jppang/X-TRACK/Hardware/README.md

## 编译
* 参见: [编译说明](https://github.com/FASTSHIFT/X-TRACK/blob/main/Software/README.md)

## 硬件修改
* PCB打样的厚度选择**0.8mm**或**1mm**。
* 去除**D4**二极管，防止充电时自动开机，导致充电变慢和发热。
* 注意**D2**二极管方向，方向是和其他二极管相反的。否则会发生开机一段时间自动关机的情况。
* GPS模块需要由**HT1818Z3G5L**更换为**ATGM336H**(购买链接在下方)，否则外壳放不下。关于接线，GPS模块的**TX**脚接板子的**T焊盘**,**RX**脚接板子的**R焊盘**。
* 地磁计**LIS3MDL**和加速度计**LSM6DSM**在该系统中作用不大，又由于芯片涨价导致整机成本过高，可以不安装。
* MCU: **AT32F403ACGU7**，如果定不到货，可以尝试[@johnsbark](https://github.com/johnsbark)设计的[改进版硬件](https://github.com/FASTSHIFT/X-TRACK/tree/main/Hardware/X-TRACK%20%E6%94%B9%E8%BF%9B%E7%89%88)方案（红框内的MCU都可以进行尝试）。
_@~ (1`XC( S{MQFDXTSZQQ
* 关于其他品牌MCU替换的性能需求: 主频 >150M，RAM >=200K，FLASH >=512K，SPI速度 >=50Mbps。 

## 特殊器件购买链接
* 电池 (选择 683030) https://detail.tmall.com/item.htm?id=634173891714
* 旋转编码器 https://item.taobao.com/item.htm?id=598028191617
* 屏幕 (选择 裸屏) https://item.taobao.com/item.htm?id=600653923469
* 调试口 (选择 4P弯针) https://item.taobao.com/item.htm?id=522574977704
* 码表底座 (选择 竖向按装拓展片孔距M3*20~21mm[塑胶材料 3g]) https://item.taobao.com/item.htm?id=599529362799
* GPS模块 (ATGM336H) https://item.taobao.com/item.htm?id=603186739934
* AON3400 (AO3400 N沟道MOS管) https://item.taobao.com/item.htm?id=522574089119
* 侧盖螺丝 https://item.taobao.com/item.htm?id=522574685586
* Pad (焊接电池线的焊盘，非实体元件)

## 焊接
* [焊接教程](https://github.com/FASTSHIFT/X-TRACK/blob/main/Hardware/%E7%84%8A%E6%8E%A5%E8%B0%83%E8%AF%95%E6%8C%87%E5%8C%97.md)

## 2.0寸屏版本
https://github.com/FASTSHIFT/X-TRACK/tree/2.0-inch by[@HanfG](https://github.com/HanfG)
