jppang/X-TRACK/Hardware/KiCad/README.md

使用KiCad來重新設計X-TRACK之原理圖及電路圖。

Utilizing KiCad to redesign X-TRACK's schematic and pcb layout.

X-Track_3D_Back_V2

X-Track_3D_Front_V2
