jppang/X-TRACK/Hardware/KiCad/doc/taobao_typec_usb2_16pins.jpg

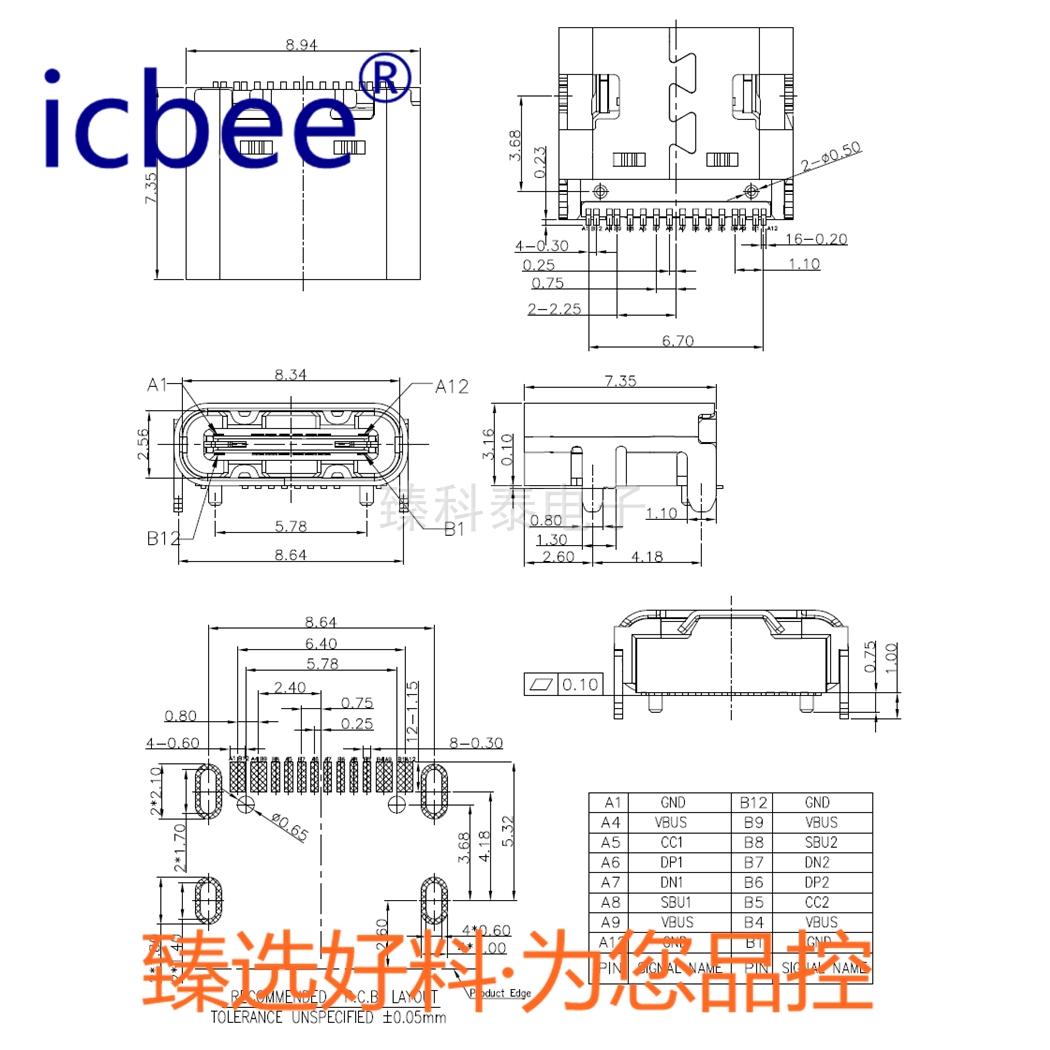
Hardware/KiCad/doc/taobao_typec_usb2_16pins.jpg
