jppang/X-TRACK/3D Model/X-Track-Back.stl

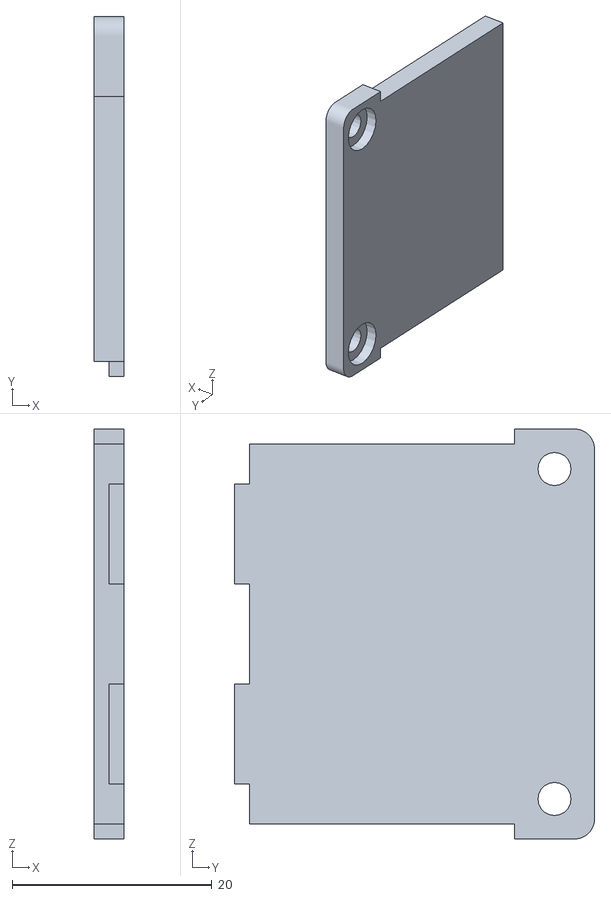
[picture p8: CAD file, 2022-02-01]
3D Model/X-Track-Back.stl
3.00 x 36.0 x 41.0
