jppang/X-TRACK/3D Model/X-Track-Front.stl

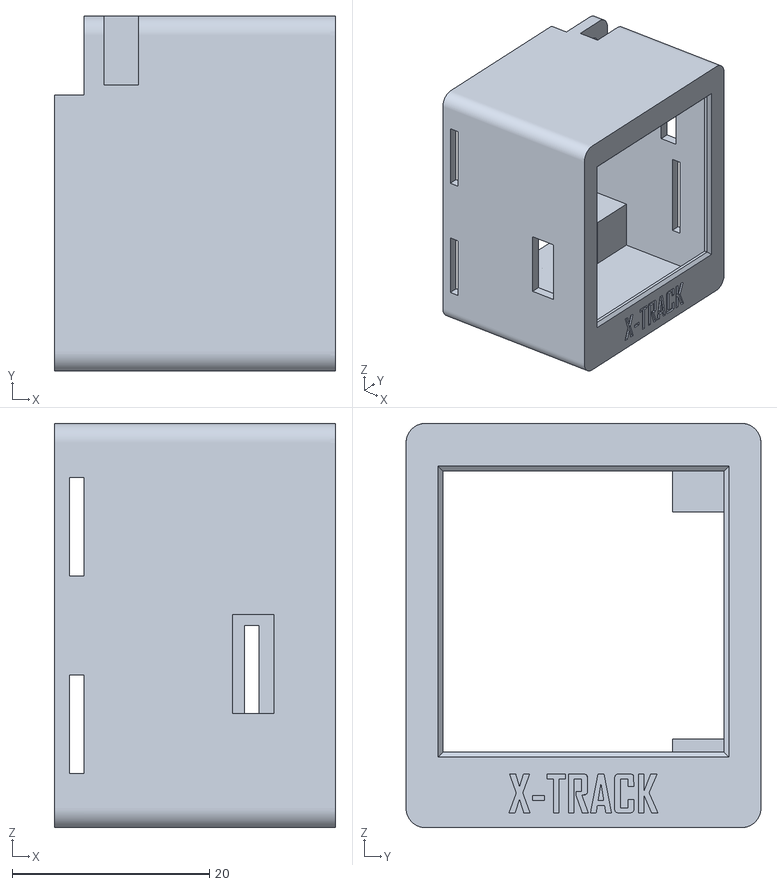
[picture p9: CAD file, 2022-02-01]
3D Model/X-Track-Front.stl
28.5 x 36.0 x 41.0
