jppang/X-TRACK/(list of files, cad)

Other CAD files:
Hardware/KiCad/doc/ZJYIPS154-12/drawing.dwg
