jppang/X-TRACK/Hardware/KiCad/X-Track.kicad_pcb

## KiCad design Hardware/KiCad/X-Track.kicad_pcb (2021-12-23)

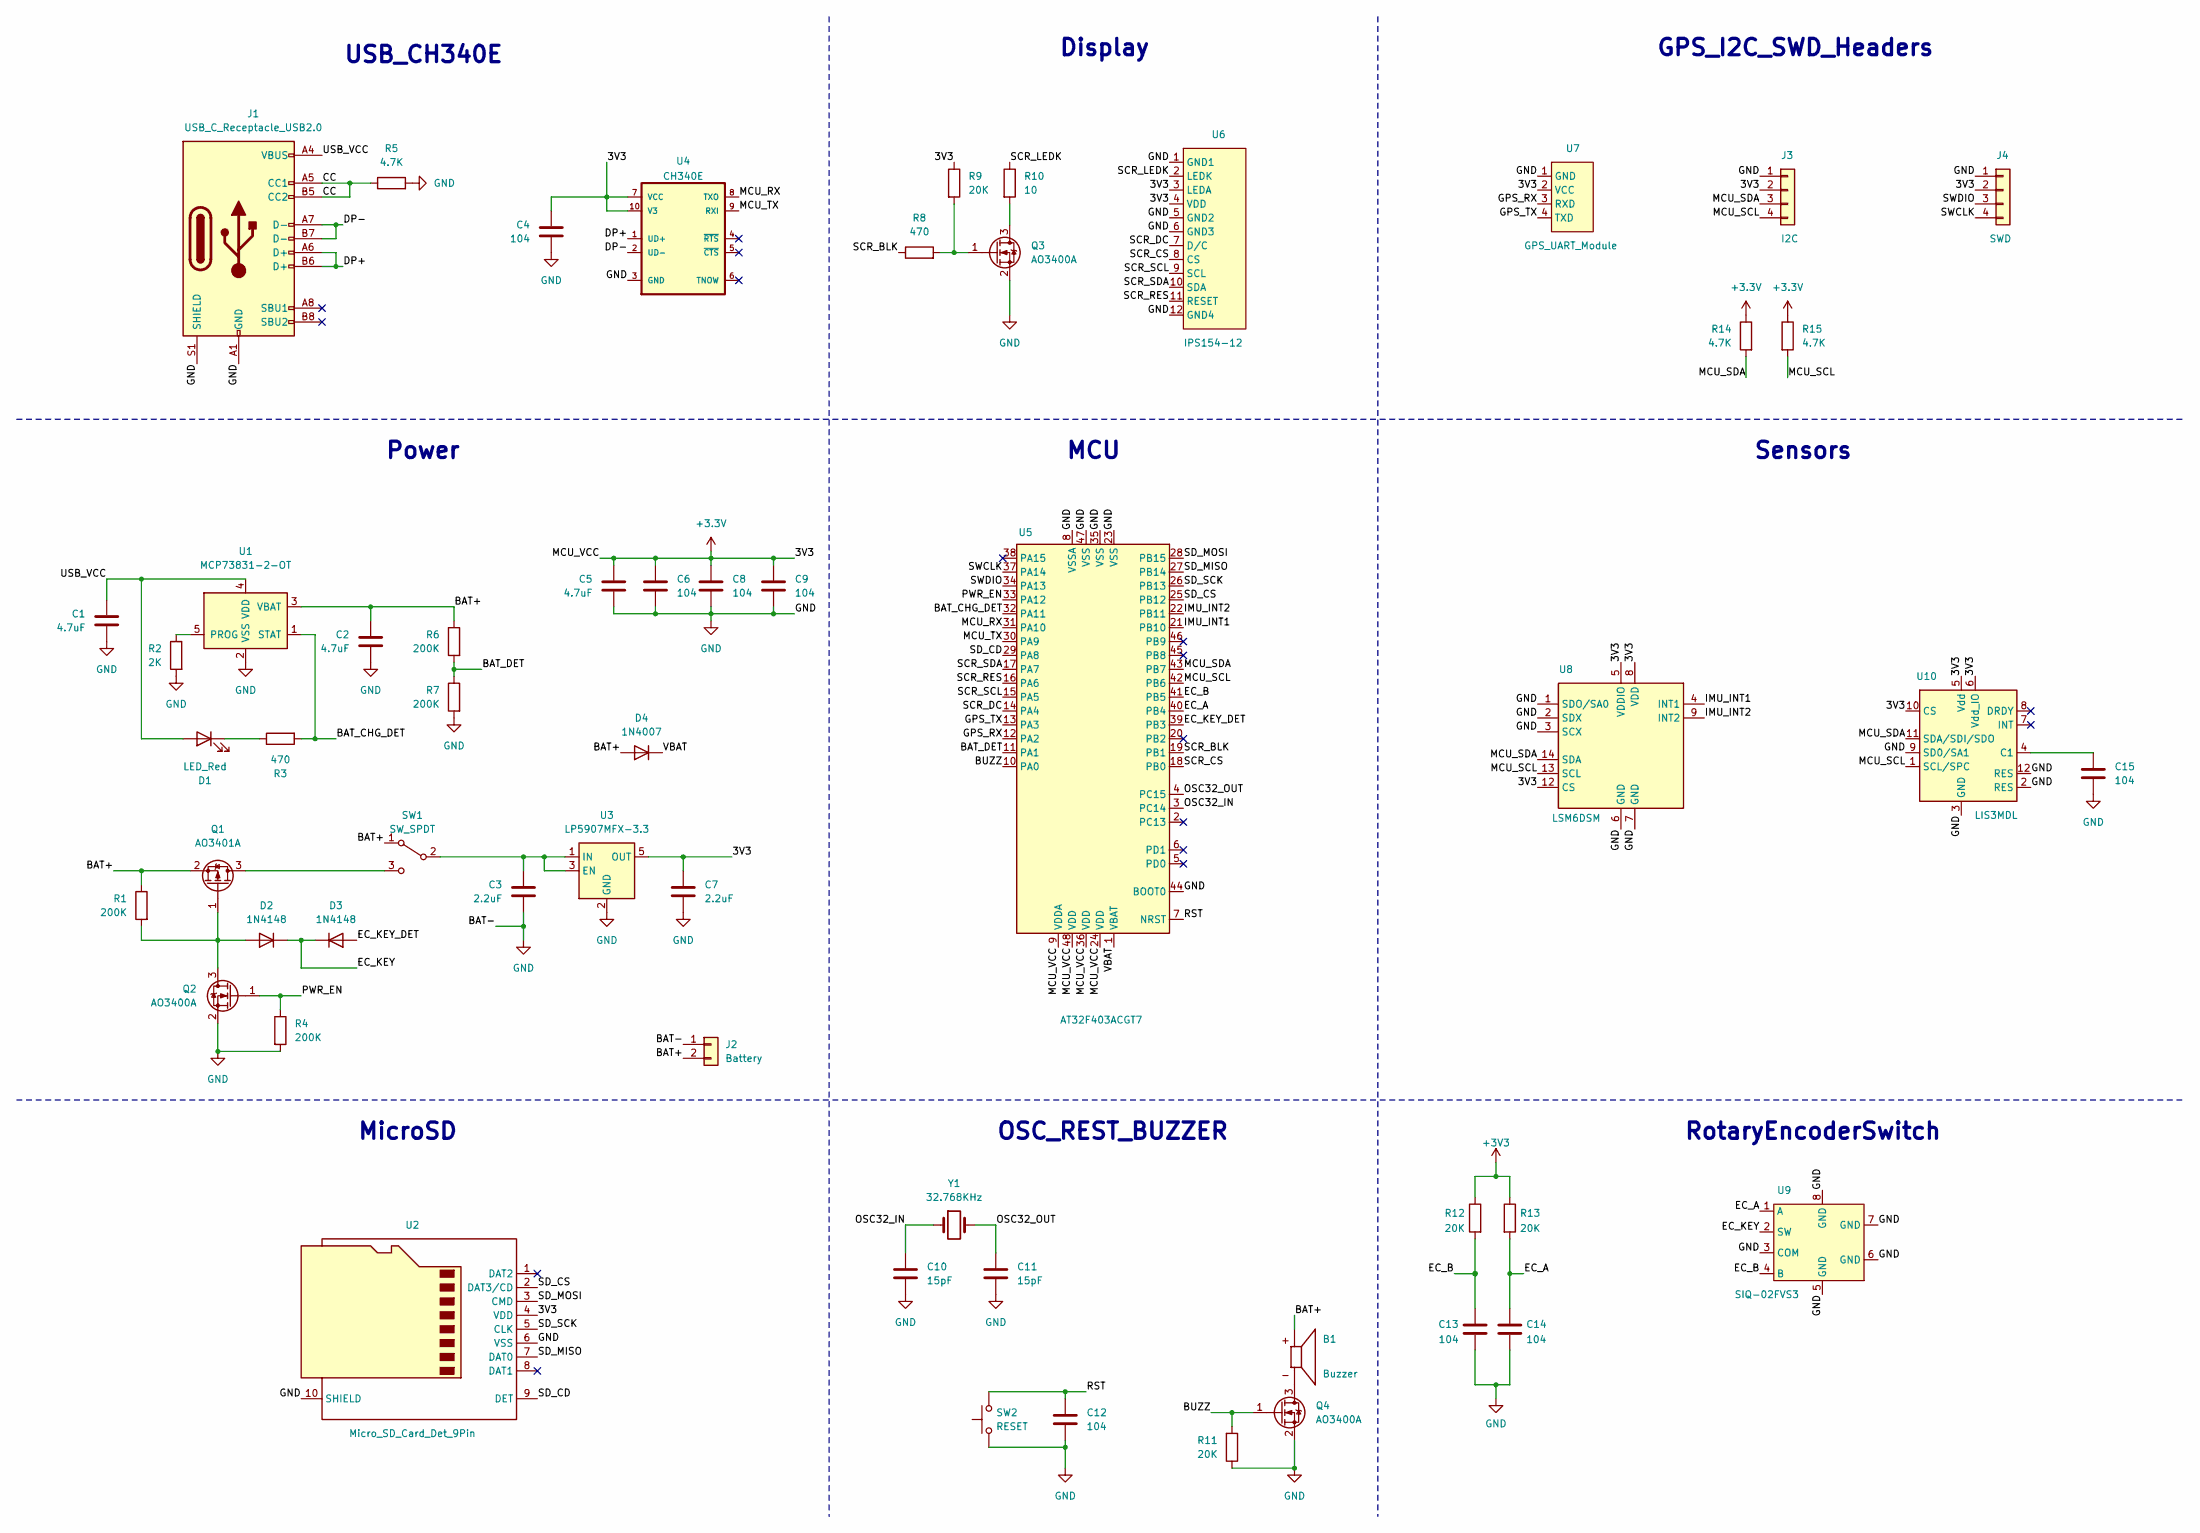
[picture p13: schematic X-Track.kicad_sch]

Parts:
B1: Buzzer; Buzzer_CMT-0502-75-SMT-TR; PARTREV 1.0
C1, C2, C5: 4.7uF; C_0805_2012Metric_Pad1.18x1.45mm_HandSolder
C3, C7: 2.2uF; C_0805_2012Metric_Pad1.18x1.45mm_HandSolder
C4, C6, C8, C9, C12, C13, C14, C15: 104; C_0805_2012Metric_Pad1.18x1.45mm_HandSolder
C10, C11: 15pF; C_0805_2012Metric_Pad1.18x1.45mm_HandSolder
D1: LED_Red; LED_0805_2012Metric_Pad1.15x1.40mm_HandSolder
D2, D3: 1N4148; D_0805_2012Metric_Pad1.15x1.40mm_HandSolder
D4: 1N4007; D_0805_2012Metric_Pad1.15x1.40mm_HandSolder
J1: USB_C_Receptacle_USB2.0; Taobao_USB_C_Receptacle_16Pin
J2: Battery; JST_PH_B2B-PH-K_1x02_P2.00mm_Vertical
J3: I2C; JST_PH_B4B-PH-K_1x04_P2.00mm_Vertical
J4: SWD; JST_PH_B4B-PH-K_1x04_P2.00mm_Vertical
Q1: AO3401A; SOT-23
Q2, Q3, Q4: AO3400A; SOT-23
R1, R4, R6, R7: 200K; R_0805_2012Metric_Pad1.20x1.40mm_HandSolder
R2: 2K; R_0805_2012Metric_Pad1.20x1.40mm_HandSolder
R3, R8: 470; R_0805_2012Metric_Pad1.20x1.40mm_HandSolder
R5, R14, R15: 4.7K; R_0805_2012Metric_Pad1.20x1.40mm_HandSolder
R9, R11, R12, R13: 20K; R_0805_2012Metric_Pad1.20x1.40mm_HandSolder
R10: 10; R_0805_2012Metric_Pad1.20x1.40mm_HandSolder
SW1: SW_SPDT; Taobao_SW_SPDT_MSK-12C01-07
SW2: RESET; SW_Push_SPST_NO_Alps_SKRK
U1: MCP73831-2-OT; SOT-23-5
U2: Micro_SD_Card_Det_9Pin; microSD_9Pins
U3: LP5907MFX-3.3; SOT-23-5
U4: CH340E; MSOP-10_3x3mm_P0.5mm
U5: AT32F403ACGT7; LQFP_LQFN_-48_7x7mm_P0.5mm
U6: IPS154-12; ZJY154T-PG04
U7: GPS_UART_Module; JST_PH_B4B-PH-K_1x04_P2.00mm_Vertical
U8: LSM6DSM; LGA-14L_2.5x3mm_P0.5mm_LSM6DSM
U9: SIQ-02FVS3; RotaryEncoder_Mitsumi_SIQ-02FVS3
U10: LIS3MDL; LGA-12_2x2mm_P0.5mm_LIS3MDL
Y1: 32.768KHz; Crystal_SMD_3215-2Pin_3.2x1.5mm

Connections:
/BAT+: B1.P, C2.2, D4.2 (A), J2.2, Q1.2 (S), R1.1, R6.1, SW1.1 (A), U1.3 (VBAT)
/BAT_CHG_DET: R3.2, U1.1 (STAT), U5.32 (PA11)
/BAT_DET: R6.2, R7.1, U5.11 (PA1)
/BUZZ: Q4.1 (G), R11.2, U5.10 (PA0)
/CC: J1.A5 (CC1), J1.B5 (CC2), R5.1
/DP+: J1.A6 (D+), J1.B6 (D+), U4.1 (UD+)
/DP-: J1.A7 (D-), J1.B7 (D-), U4.2 (UD-)
/EC_A: C14.1, R13.2, U5.40 (PB4), U9.1 (A)
/EC_B: C13.1, R12.2, U5.41 (PB5), U9.4 (B)
/EC_KEY: D2.1 (K), D3.1 (K), U9.2 (SW)
/EC_KEY_DET: D3.2 (A), U5.39 (PB3)
/GPS_RX: U5.12 (PA2), U7.3 (RXD)
/GPS_TX: U5.13 (PA3), U7.4 (TXD)
/IMU_INT1: U5.21 (PB10), U8.4 (INT1)
/IMU_INT2: U5.22 (PB11), U8.9 (INT2)
/MCU_RX: U4.8 (TXO), U5.31 (PA10)
/MCU_SCL: J3.4, R15.2, U5.42 (PB6), U8.13 (SCL), U10.1 (SCL/SPC)
/MCU_SDA: J3.3, R14.2, U5.43 (PB7), U8.14 (SDA), U10.11 (SDA/SDI/SDO)
/MCU_TX: U4.9 (RXI), U5.30 (PA9)
/OSC32_IN: C10.2, U5.3 (PC14), Y1.1
/OSC32_OUT: C11.1, U5.4 (PC15), Y1.2
/PWR_EN: Q2.1 (G), R4.1, U5.33 (PA12)
/RST: C12.1, SW2.2, U5.7 (NRST); also elsewhere on the board
/SCR_BLK: R8.1, U5.19 (PB1)
/SCR_CS: U5.18 (PB0), U6.8 (CS)
/SCR_DC: U5.14 (PA4), U6.7 (D/C)
/SCR_LEDK: R10.1, U6.2 (LEDK)
/SCR_RES: U5.16 (PA6), U6.11 (RESET)
/SCR_SCL: U5.15 (PA5), U6.9 (SCL)
/SCR_SDA: U5.17 (PA7), U6.10 (SDA)
/SD_CD: U2.9 (DET), U5.29 (PA8)
/SD_CS: U2.2 (DAT3/CD), U5.25 (PB12)
/SD_MISO: U2.7 (DAT0), U5.27 (PB14)
/SD_MOSI: U2.3 (CMD), U5.28 (PB15)
/SD_SCK: U2.5 (CLK), U5.26 (PB13)
/SWCLK: J4.4, U5.37 (PA14)
/SWDIO: J4.3, U5.34 (PA13)
/USB_VCC: C1.1, D1.2 (A), J1.A4 (VBUS), J1.A9 (VBUS), J1.B4 (VBUS), J1.B9 (VBUS), U1.4 (VDD)
/VBAT: D4.1 (K), U5.1 (VBAT)
GND: C1.2, C2.1, C3.2, C4.2, C5.2, C6.2, C7.2, C8.2, C9.2, C10.1, C11.2, C12.2, C13.2, C14.2, C15.2, J1.A1 (GND), J1.A12 (GND), J1.B1 (GND), J1.B12 (GND), J1.S1 (SHIELD), J2.1, J3.1, J4.1, Q2.2 (S), Q3.2 (S), Q4.2 (S), R2.2, R4.2, R5.2, R7.2, R11.1, SW2.1, U1.2 (VSS), U2.6 (VSS), U2.10 (SHIELD), U3.2 (GND), U4.3 (GND), U5.8 (VSSA), U5.23 (VSS), U5.35 (VSS), U5.44 (BOOT0), U5.47 (VSS), U6.1 (GND1), U6.5 (GND2), U6.6 (GND3), U6.12 (GND4), U7.1 (GND), U8.1 (SDO/SA0), U8.2 (SDX), U8.3 (SCX), U8.6 (GND), U8.7 (GND), U9.3 (COM), U9.5 (GND), U9.6 (GND), U9.7 (GND), U9.8 (GND), U10.2 (RES), U10.3 (GND), U10.9 (SD0/SA1), U10.12 (RES); also elsewhere on the board
unnamed: B1.N, Q4.3 (D)
unnamed: C3.1, SW1.2 (B), U3.1 (IN), U3.3 (EN)
unnamed: C15.1, U10.4 (C1)
unnamed: D1.1 (K), R3.1
unnamed: D2.2 (A), Q1.1 (G), Q2.3 (D), R1.2
unnamed: Q1.3 (D), SW1.3 (C)
unnamed: Q3.1 (G), R8.2, R9.2
unnamed: Q3.3 (D), R10.2
unnamed: R2.1, U1.5 (PROG)

Notes on the sheet:
RotaryEncoderSwitch
OSC_REST_BUZZER
GPS_I2C_SWD_Headers
MicroSD
USB_CH340E
Sensors
Power
Display
MCU

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
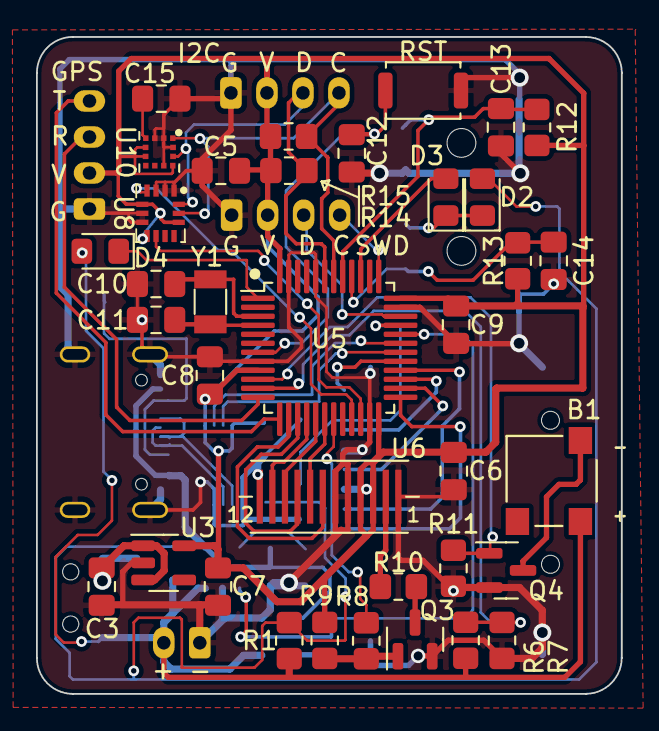
[picture p14: board X-Track.kicad_pcb from above]

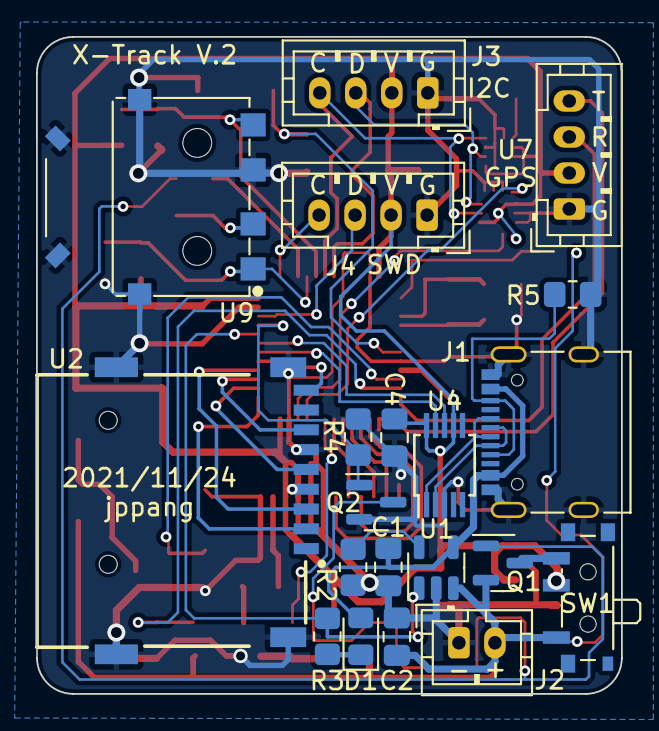
[picture p15: board X-Track.kicad_pcb from below]

Board: 2 copper layers, 32.5 x 36.5 mm, 56 parts (20 on the bottom side), 50 nets.

Other parts of the board:
RST: RESET; SW_Push_SPST_NO_Alps_SKRK

Their connections:
/RST: RST.2; also elsewhere on the board
GND: RST.1; also elsewhere on the board
