jppang/X-TRACK/Software/X-Track/MDK-ARM_F435/USER/main.cpp

/*
 * MIT License
 * Copyright (c) 2021 _VIFEXTech
 *
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
 * THE SOFTWARE IS PROVIDED "AS IS", WITHOUT WARRANTY OF ANY KIND, EXPRESS OR
 * IMPLIED, INCLUDING BUT NOT LIMITED TO THE WARRANTIES OF MERCHANTABILITY,
 * FITNESS FOR A PARTICULAR PURPOSE AND NONINFRINGEMENT. IN NO EVENT SHALL THE
 * AUTHORS OR COPYRIGHT HOLDERS BE LIABLE FOR ANY CLAIM, DAMAGES OR OTHER
 * LIABILITY, WHETHER IN AN ACTION OF CONTRACT, TORT OR OTHERWISE, ARISING FROM,
 * OUT OF OR IN CONNECTION WITH THE SOFTWARE OR THE USE OR OTHER DEALINGS IN THE
 * SOFTWARE.
 */
#include "Arduino.h"
#include "App/App.h"
#include "HAL/HAL.h"
#include "lvgl/lvgl.h"
#include "lv_port/lv_port.h"

static void setup()
{
    HAL::HAL_Init();
    lv_init();
    lv_port_init();

    App_Init();

    HAL::Power_SetEventCallback(App_Uninit);
    HAL::Memory_DumpInfo();
}

static void loop()
{
    HAL::HAL_Update();
    lv_task_handler();
    __WFI();
}

/**
  * @brief  Main Function
  * @param  None
  * @retval None
  */
int main(void)
{
    system_clock_config();
    nvic_priority_group_config(NVIC_PRIORITY_GROUP_2);
    Delay_Init();
    setup();
    for(;;)loop();
}
