jppang/X-TRACK/Software/X-Track/USER/App/Utils/lv_img_png/PNGdec/examples/png_benchmark/octocat_32bpp.h

//
// octocat_32bpp
// Data size = 12735 bytes
//
// PNG, Compression=Flate, Size: 240 x 200, 32-Bpp
//
// for non-Arduino builds...
#ifndef PROGMEM
#define PROGMEM
#endif
const uint8_t octocat_32bpp[] PROGMEM = {
	0x89,0x50,0x4e,0x47,0x0d,0x0a,0x1a,0x0a,0x00,0x00,0x00,0x0d,0x49,0x48,0x44,0x52,
	0x00,0x00,0x00,0xf0,0x00,0x00,0x00,0xc8,0x08,0x06,0x00,0x00,0x00,0xd6,0x7c,0x6c,
	0x52,0x00,0x00,0x00,0x06,0x62,0x4b,0x47,0x44,0x00,0xff,0x00,0xff,0x00,0xff,0xa0,
	0xbd,0xa7,0x93,0x00,0x00,0x20,0x00,0x49,0x44,0x41,0x54,0x78,0xda,0xed,0x9d,0x77,
	0x78,0x1c,0xd5,0xb9,0xff,0x3f,0x33,0xb3,0x4d,0xab,0xb6,0x6a,0xb6,0xaa,0x67,0x6d,
	0xd9,0x72,0x05,0x0c,0xd8,0x18,0xb0,0x0d,0xa6,0x07,0x08,0x25,0x09,0x10,0x12,0xd2,
	0x08,0x4a,0xc2,0x25,0x9d,0x24,0xa4,0x91,0x9b,0x9b,0x5f,0xca,0x4d,0x42,0x92,0x9b,
	0xe4,0x92,0x0b,0x09,0xe2,0x86,0x70,0x93,0x00,0xa1,0x27,0x10,0x6a,0x42,0x2f,0xc1,
	0x80,0x01,0x03,0x96,0xe5,0xb6,0xe3,0x22,0xab,0x6b,0xd5,0x56,0xdb,0x66,0xe6,0xf7,
	0xc7,0x8c,0x64,0xc9,0x96,0xad,0x5d,0xd5,0x2d,0xe7,0xfb,0x3c,0xf3,0x48,0x5a,0xed,
	0x94,0x73,0xe6,0xfd,0x9e,0xf7,0x9c,0xf7,0xbc,0x05,0x04,0x04,0x04,0x04,0x04,0x04,
	0x04,0x04,0x04,0x04,0x04,0x92,0x80,0x94,0xed,0x1d,0xe0,0x57,0x55,0x2f,0xe0,0xb4,
	0xfb,0x42,0x97,0x24,0x29,0xba,0x2b,0x10,0x88,0x08,0xd1,0x98,0x5d,0xcc,0xf7,0xfb,
	0x5d,0xa6,0x69,0xba,0x00,0x87,0xfd,0x51,0x5c,0x51,0x94,0xd0,0x8e,0x9d,0x3b,0x0d,
	0xd1,0x3b,0x82,0xc0,0x43,0xe4,0x3d,0x0b,0xb8,0x17,0xc8,0x1f,0x12,0x12,0xa0,0x03,
	0xd8,0x03,0xbc,0x09,0xbc,0x0c,0x3c,0x1b,0xd0,0xb4,0x6d,0x42,0x54,0xa6,0xfd,0x5d,
	0x54,0x03,0x6b,0xed,0x63,0x25,0x30,0x1f,0x28,0x03,0xdc,0xf6,0x57,0x06,0x81,0xff,
	0x08,0x68,0xda,0x4f,0x45,0x6f,0x09,0x02,0x0f,0x09,0xcd,0xdd,0xc0,0x25,0xe3,0x7c,
	0x4d,0x07,0x76,0x01,0xf7,0x03,0x77,0x06,0x34,0xed,0x75,0x21,0x36,0x53,0xd6,0xff,
	0xf3,0x81,0x0f,0xd9,0xef,0x60,0x39,0xe0,0x1a,0xe7,0x94,0x00,0xb0,0x20,0xa0,0x69,
	0xa6,0xe8,0xbd,0x2c,0x27,0xb0,0x5f,0x55,0xf3,0x6d,0x6d,0xeb,0x4a,0xf2,0xd4,0x77,
	0x80,0xdf,0x01,0xb7,0x07,0x34,0x2d,0x28,0x44,0x28,0xe9,0x7e,0xf7,0x00,0xef,0x03,
	0xae,0x06,0x4e,0x99,0xc0,0x25,0xd6,0x06,0x34,0xed,0x45,0xd1,0x93,0x16,0xe4,0x2c,
	0x6e,0xfb,0x85,0x13,0x20,0x2f,0xb6,0xa6,0xf8,0x15,0xb0,0xc7,0xaf,0xaa,0x37,0xfa,
	0x55,0x75,0xa1,0x10,0xa3,0x84,0x88,0x5b,0xe6,0x57,0xd5,0xef,0x00,0x3b,0x81,0x3f,
	0x4f,0x90,0xbc,0x24,0x30,0x63,0x12,0x1a,0x38,0x4b,0x04,0xea,0x2f,0xc0,0xa5,0x53,
	0x70,0xa9,0x28,0x70,0x0f,0xf0,0xff,0x02,0x9a,0xb6,0x55,0x88,0xd4,0xa1,0xc4,0x05,
	0xbe,0x0e,0x7c,0x7a,0x84,0xad,0x61,0x32,0xd8,0x0a,0x2c,0x0f,0x68,0x9a,0x2e,0x7a,
	0x37,0x4b,0x09,0xec,0x57,0x55,0x07,0xb0,0x1f,0x28,0x9d,0xc2,0xcb,0xea,0xc0,0x1f,
	0x80,0xef,0x06,0x34,0x6d,0xaf,0x20,0xae,0x5a,0x00,0x7c,0x15,0xb8,0x16,0xc8,0x9d,
	0xe2,0xcb,0x2f,0x08,0x68,0xda,0x2e,0x41,0xdf,0xec,0x9d,0x42,0x1f,0x35,0xc5,0xe4,
	0x05,0x50,0x80,0x4f,0x02,0x4d,0x7e,0x55,0xfd,0x81,0xbd,0xc6,0xce,0xca,0xc1,0xd1,
	0xaf,0xaa,0x9f,0x01,0xb6,0x01,0xdf,0x99,0x06,0xf2,0x02,0x9c,0x2e,0xa8,0x6b,0xc1,
	0x91,0xa5,0xed,0x3e,0x79,0x1a,0xaf,0x9d,0x03,0x7c,0x1b,0xf8,0x84,0x5f,0x55,0xaf,
	0x0b,0x68,0xda,0x9f,0xa7,0x91,0x2c,0x25,0x40,0x89,0x3d,0x35,0xcd,0xb3,0x0f,0x8f,
	0xfd,0x5e,0x1d,0xf6,0xa0,0x12,0xb3,0x67,0x07,0x31,0x60,0x00,0x08,0x01,0x7d,0x40,
	0x37,0xd0,0x15,0xd0,0xb4,0xfe,0x29,0x7c,0x9e,0xf5,0xc0,0x7f,0x03,0xc7,0x4c,0xf3,
	0xfb,0x3b,0x09,0xb8,0x55,0xd0,0x37,0x7b,0x09,0xbc,0x7a,0x06,0xee,0x51,0x05,0xfc,
	0xc9,0xaf,0xaa,0x57,0x01,0x57,0x27,0xb3,0x97,0xec,0x57,0x55,0x09,0x6b,0xff,0xb3,
	0x1a,0x58,0x0a,0x2c,0x02,0xfc,0x40,0x0d,0xa0,0xda,0x9f,0x17,0x8f,0x98,0x41,0x25,
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
