jppang/X-TRACK/Software/X-Track/USER/App/Utils/lv_img_png/PNGdec/examples/png_benchmark/octocat_4bpp.h

//
// octocat_4bpp
// Data size = 1808 bytes
//
// PNG, Compression=Flate, Size: 240 x 200, 4-Bpp
//
// for non-Arduino builds...
#ifndef PROGMEM
#define PROGMEM
#endif
const uint8_t octocat_4bpp[] PROGMEM = {
	0x89,0x50,0x4e,0x47,0x0d,0x0a,0x1a,0x0a,0x00,0x00,0x00,0x0d,0x49,0x48,0x44,0x52,
	0x00,0x00,0x00,0xf0,0x00,0x00,0x00,0xc8,0x04,0x03,0x00,0x00,0x00,0x24,0x52,0x71,
	0x61,0x00,0x00,0x00,0x30,0x50,0x4c,0x54,0x45,0x00,0x03,0x00,0x06,0x0a,0x05,0x22,
	0x1e,0x1d,0x45,0x5c,0x65,0x6b,0x57,0x4f,0xad,0x5b,0x53,0xb6,0x75,0x6a,0xa3,0x84,
	0x72,0x67,0x96,0xa8,0xc7,0x9e,0x89,0x7a,0xbb,0xe4,0x83,0xbb,0xcc,0xd9,0xc4,0xc0,
	0x9c,0xd9,0xf0,0xf5,0xca,0xb3,0xfa,0xfc,0xf9,0x45,0x09,0xf7,0x95,0x00,0x00,0x00,
	0x01,0x74,0x52,0x4e,0x53,0x00,0x40,0xe6,0xd8,0x66,0x00,0x00,0x06,0x8e,0x49,0x44,
	0x41,0x54,0x78,0xda,0xed,0xdb,0xbf,0x4b,0x23,0x59,0x1c,0x00,0xf0,0xb9,0x29,0x17,
	0x02,0x9b,0xfc,0x05,0x93,0x17,0x41,0xbd,0xe5,0x8e,0x25,0x36,0x01,0xd9,0x26,0x08,
	0x62,0xb3,0xdd,0x04,0x04,0x59,0xab,0x5c,0xb5,0xec,0x81,0x08,0xc1,0xe6,0x8a,0xd8,
	0x2c,0x1e,0x29,0x4e,0x0c,0x32,0x8d,0xdb,0x2e,0x81,0x34,0x6e,0x6d,0xe9,0xc1,0x36,
	0xa7,0xa7,0x8d,0x44,0xa6,0xb8,0x63,0x55,0x06,0x16,0xad,0x4e,0x38,0x58,0x36,0x37,
	0xf3,0xde,0x9b,0xdf,0xdf,0xc9,0xbc,0x6c,0xbe,0x2f,0x83,0xe7,0xbc,0x46,0x9d,0x17,
	0xdf,0x27,0xdf,0xef,0xfb,0xce,0x7b,0x33,0x13,0x55,0x94,0xbc,0x3d,0xfa,0x46,0x08,
	0xd1,0x64,0xff,0x06,0xd4,0x54,0x42,0xc6,0x1b,0x88,0xfd,0x02,0x16,0x2c,0x2e,0xb3,
	0x97,0xe3,0xc1,0xa2,0x43,0xb9,0xaf,0xd6,0x30,0xa6,0x58,0x5c,0xf6,0xde,0x25,0x2a,
	0x4c,0xc6,0x70,0x71,0x61,0x32,0xc6,0x6b,0x71,0x61,0x4d,0xfc,0xa5,0x04,0xad,0xb6,
	0xc2,0x32,0x74,0x94,0x48,0x84,0x09,0x20,0xb8,0xb6,0x2a,0x15,0x26,0xb1,0x03,0x49,
	0x0d,0x1b,0x16,0x6e,0x39,0x3c,0x35,0x58,0xcb,0xe1,0x1c,0xce,0x4f,0xa7,0x1c,0xce,
	0x0a,0x56,0x1e,0x1a,0xac,0x3d,0x3a,0x38,0xbb,0x39,0xd6,0xb2,0x82,0x49,0x56,0xa7,
	0xd3,0xa4,0x21,0x13,0x92,0x4d,0xc8,0xea,0x43,0x84,0xb5,0x8c,0x32,0x3d,0x51,0xc8,
	0xea,0xc3,0x84,0xb5,0x8c,0x32,0x9d,0x1d,0x4c,0x32,0xca,0x74,0x86,0xb0,0x96,0x51,
	0xa6,0x1f,0x21,0x4c,0x32,0x9a,0xe2,0x1c,0x9e,0x22,0xac,0x65,0x54,0x5b,0xff,0x07,
	0xb8,0x58,0x22,0xc5,0x22,0x7c,0x9c,0x14,0xe5,0xc1,0xcb,0x2d,0xc3,0x69,0xfb,0xad,
	0xd6,0xd2,0x52,0x9d,0x1f,0x9b,0x59,0x5a,0x6a,0xb5,0xb6,0xd8,0xf1,0xcd,0xba,0x14,
	0x78,0xd9,0x48,0x6f,0x9b,0x12,0x60,0xdb,0x3d,0xb8,0x65,0x2d,0xe6,0xf1,0xe3,0x96,
	0x61,0xec,0xa1,0xc3,0xb3,0x1e,0xeb,0x35,0xc3,0x88,0x1d,0xb3,0x8c,0x0d,0x6c,0x38,
	0xee,0x82,0xcd,0x32,0xea,0xb8,0xf0,0x8a,0x98,0x6b,0xcb,0x7b,0xa8,0xf0,0x8c,0x71,
	0x2b,0xda,0x82,0x21,0x4f,0x0e,0xcf,0x1f,0x08,0xc3,0xc1,0x90,0x27,0x87,0xb7,0x6e,
	0xc5,0x9b,0x81,0x08,0xcf,0xf2,0x80,0xef,0x86,0xc3,0xaf,0x49,0x9e,0xd7,0x67,0x6d,
	0xe0,0xc1,0x2b,0xde,0xd8,0x89,0x72,0xa0,0x6f,0x1f,0x0f,0xe6,0x01,0x0f,0x69,0x83,
	0xe1,0x40,0x9f,0x55,0xc7,0x82,0x79,0xa6,0xef,0xd8,0xe0,0x5f,0x13,0x03,0x76,0xfb,
	0x36,0xb0,0xe0,0xf9,0x60,0x50,0x70,0xc8,0xa1,0xbe,0x3d,0x2c,0xf8,0x17,0x6f,0xf0,
	0x8f,0x3f,0xbd,0x4b,0x82,0x69,0x17,0xeb,0xbb,0xc1,0x82,0xbd,0x4c,0x7f,0xd1,0x75,
	0xfd,0x04,0xca,0xf5,0x1d,0xef,0x62,0x7d,0x16,0x12,0x3c,0xe3,0xc1,0xc7,0xf6,0xe8,
	0x6b,0x30,0xcc,0xba,0x78,0x5f,0x1d,0x07,0x9e,0xf5,0xa2,0x5a,0xed,0xda,0xc3,0x43,
	0xf0,0xc9,0x17,0xbd,0xe9,0x74,0x45,0xaa,0xeb,0x1b,0x61,0x35,0x0c,0x0f,0x87,0xff,
	0x9e,0x38,0x09,0x7d,0x07,0x4c,0xf2,0xf0,0x7e,0x6d,0xd8,0x74,0xba,0x58,0xdf,0x2e,
	0x0e,0xec,0x15,0xf5,0x3f,0xc3,0xa1,0x0d,0xaf,0x43,0xf0,0xf1,0xba,0x93,0xec,0x75,
	0x0e,0x7f,0xc2,0x81,0x7f,0x74,0xe1,0x63,0x0a,0xaf,0x25,0xc0,0x5d,0x3a,0xc9,0x52,
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
