jppang/X-TRACK/Software/X-Track/USER/App/Utils/lv_img_png/PNGdec/examples/png_benchmark/octocat_8bpp.h

//
// octocat_8bpp
// Data size = 1800 bytes
//
// PNG, Compression=Flate, Size: 240 x 200, 8-Bpp
//
// for non-Arduino builds...
#ifndef PROGMEM
#define PROGMEM
#endif
const uint8_t octocat_8bpp[] PROGMEM = {
	0x89,0x50,0x4e,0x47,0x0d,0x0a,0x1a,0x0a,0x00,0x00,0x00,0x0d,0x49,0x48,0x44,0x52,
	0x00,0x00,0x00,0xf0,0x00,0x00,0x00,0xc8,0x08,0x03,0x00,0x00,0x00,0xe1,0xa2,0x9c,
	0x60,0x00,0x00,0x00,0x33,0x50,0x4c,0x54,0x45,0x57,0x61,0x77,0x09,0x08,0x06,0x22,
	0x1e,0x1d,0x2d,0x2d,0x2d,0x44,0x5c,0x67,0x6a,0x57,0x4d,0xad,0x5b,0x52,0xb7,0x74,
	0x6a,0xa2,0x84,0x73,0x6a,0x95,0xa8,0xc7,0x9e,0x8a,0x7b,0xbb,0xe4,0x85,0xbb,0xcc,
	0xdc,0xc3,0xc0,0x9c,0xd9,0xf1,0xf5,0xca,0xb3,0xfd,0xfb,0xf7,0x24,0xdc,0x40,0xfd,
	0x00,0x00,0x00,0x01,0x74,0x52,0x4e,0x53,0x00,0x40,0xe6,0xd8,0x66,0x00,0x00,0x06,
	0x83,0x49,0x44,0x41,0x54,0x78,0xda,0xed,0xdd,0xe1,0xb6,0x9b,0x20,0x0c,0x00,0x60,
	0x05,0xac,0x42,0x95,0xbb,0xf7,0x7f,0xda,0x29,0xb6,0x0a,0x08,0x08,0x8a,0xc7,0x60,
	0x93,0x1f,0xdb,0xb9,0xab,0x74,0xf9,0x1a,0x04,0x44,0xbb,0x55,0x15,0x06,0x06,0xc6,
	0x4f,0x07,0x99,0xa3,0xf8,0xbf,0x23,0x31,0x97,0x0b,0x13,0xba,0xfc,0x2f,0x38,0x0e,
	0xbe,0x20,0xa3,0x8b,0xdf,0xfe,0x74,0x46,0x99,0x93,0xba,0xf4,0xcd,0x33,0xa5,0x94,
	0x2f,0xab,0x0b,0xdf,0x3a,0x73,0x56,0x59,0xf2,0xba,0xec,0x8d,0x2f,0xc9,0xeb,0x7c,
	0x66,0xa4,0x34,0x30,0xb9,0xe6,0x5d,0x09,0x58,0xaf,0x2b,0xb7,0xd8,0x63,0x93,0xde,
	0x14,0x10,0x98,0x44,0x1e,0x66,0x37,0x20,0xc5,0x82,0x55,0x7a,0x24,0x6f,0x00,0x07,
	0xe7,0x0f,0x04,0x23,0xf8,0x61,0x60,0x82,0x60,0x04,0x23,0x18,0xc1,0x38,0x4a,0x23,
	0x18,0xc1,0x08,0xfe,0x15,0x70,0x85,0xe0,0x87,0x7b,0x11,0x8c,0x5d,0x1a,0x87,0xe9,
	0xb2,0xc5,0x84,0xfc,0x96,0x98,0x90,0xdf,0x12,0x13,0x04,0x3f,0x5b,0x4c,0xc8,0x6f,
	0x89,0x09,0x82,0x9f,0x2d,0x26,0x08,0x7e,0xb6,0x98,0x20,0xf8,0xd9,0x62,0x82,0x60,
	0x04,0x3f,0x4a,0x4c,0x10,0x8c,0x60,0x04,0x97,0x2c,0x26,0x08,0x46,0xf0,0x18,0x75,
	0x5d,0xcf,0xbf,0xd6,0xf1,0xc7,0xd3,0x31,0x22,0x8f,0x07,0x05,0xa6,0x4d,0xd7,0x75,
	0x62,0x8d,0x6e,0x8a,0x66,0x0a,0xaa,0x42,0x1d,0xa3,0x42,0xfd,0xa1,0x7a,0x59,0x18,
	0xc7,0x8f,0x47,0x16,0x03,0x6e,0x8c,0xdc,0x8f,0x47,0xd7,0x14,0x01,0xfe,0x70,0xff,
	0xcc,0xd8,0xe7,0x39,0x1b,0x34,0xe0,0xc1,0xb4,0xdb,0xe6,0xbe,0x0d,0xb7,0xd1,0x75,
	0x58,0x47,0x61,0x83,0x69,0x0c,0x37,0x21,0x42,0x45,0x86,0x00,0x6e,0xf2,0x72,0x67,
	0x72,0x03,0x17,0x7c,0x81,0x37,0x20,0xbe,0x1f,0x4c,0xaf,0xf0,0xfa,0xc5,0xb7,0x83,
	0xc7,0xf1,0xea,0xef,0xef,0x1a,0x31,0x05,0x09,0xb6,0xbd,0xff,0x54,0xa4,0xfb,0xb6,
	0xed,0x44,0x07,0x11,0xdc,0x08,0x47,0xda,0xe9,0x64,0x67,0x3b,0xa7,0xf8,0x66,0x30,
	0xf5,0x79,0xd3,0xc4,0x9e,0x76,0xae,0xd3,0xf8,0x66,0xb0,0xd9,0xa1,0xff,0xfd,0x3b,
	0x26,0xf6,0xb6,0xeb,0xa0,0x81,0x69,0xc0,0x1b,0x2f,0xf6,0xb7,0x73,0x94,0xf8,0x5e,
	0x70,0xe7,0x48,0x7c,0x10,0x6d,0x2b,0x92,0xc1,0x6b,0xab,0x9d,0x12,0xdf,0x0b,0x76,
	0x14,0x78,0x78,0xa9,0x18,0xe2,0xc5,0x76,0x2b,0xa3,0xc4,0x14,0x14,0xb8,0xd9,0x82,
	0x3f,0x99,0xcf,0xb9,0x47,0x83,0x8d,0x56,0x46,0xbb,0x06,0x14,0xb8,0x73,0x54,0x4a,
	0x88,0x4f,0xee,0xb1,0xe0,0x41,0x79,0xdb,0xb5,0x55,0xb8,0x4f,0xdf,0xba,0x6b,0xd9,
	0x6d,0x0a,0x2c,0x86,0xa5,0x5c,0x22,0x52,0x3c,0x1e,0xd6,0x4e,0x95,0x6d,0x97,0x56,
	0x46,0x9f,0x06,0x05,0xde,0xf6,0x68,0x55,0xa1,0xb4,0x12,0xab,0x4f,0x68,0xed,0xd6,
	0x7b,0x7d,0xfa,0x56,0xb0,0xa3,0x47,0x6b,0xe0,0x21,0x0d,0x2c,0xdc,0xa3,0x1d,0x6c,
	0xb0,0x78,0xb5,0xc3,0xf0,0x3d,0x1d,0x45,0x2c,0x78,0x6c,0xd0,0x0e,0x62,0x6d,0x05,
	0x16,0x4c,0x37,0xe0,0xaf,0x55,0x45,0x9b,0x00,0x36,0x5a,0x85,0xc0,0xf7,0xde,0x2e,
	0xb5,0x06,0xdb,0x43,0xe0,0x61,0x39,0x05,0x34,0xf0,0x50,0x0a,0xf8,0xf5,0x43,0xe0,
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
