jppang/X-TRACK/(commit log)

2021-12-23 Create .gitkeep
    KiCad Implementation of X-TRACK.
2021-12-23 Add files via upload
    Add schematic and pcb files.
    [X-Track.kicad_pcb, X-Track.kicad_sch]
2021-12-23 Create .gitkeep
    Documents related to devices.
2021-12-23 Add files via upload
    Documents related to display.
    [drawing.dwg]
2021-12-23 Create README.md
    X-TRACK by KiCad.
2021-12-23 Update README.md
    Add 3D images of pcb.
2022-02-01 使用TinkerCad設計的外殼
    前殼與背殼使用3D列印FDM的方式。
    [X-Track-Back.stl, X-Track-Front.stl]
